hausen/tdbfs/README.md

# Teacher's Best Friend

Tired of manually taking the attendance of your students? Have them scan their student ID smartcards (of the MIFARE type) and save time.

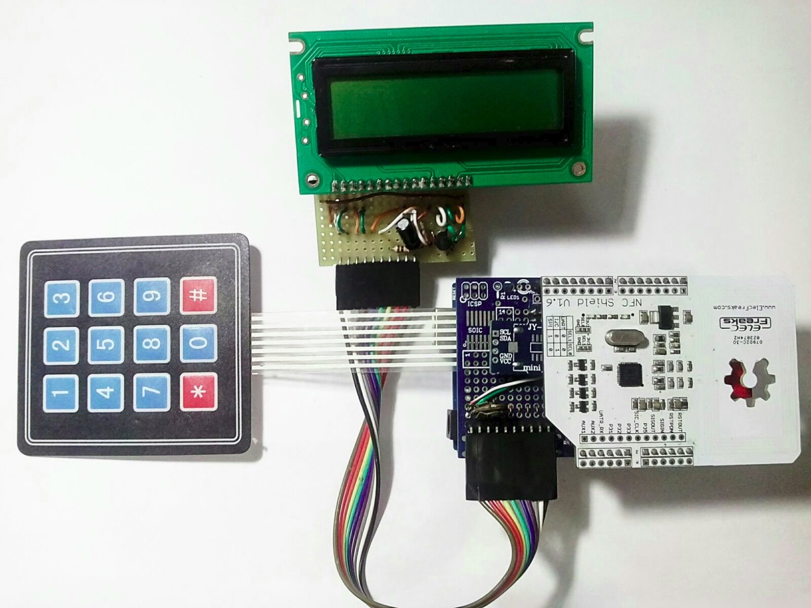
[picture p1: doc/hardware.jpg]
Image of the hardware
